glloq/Orchestrion_ukulele/img/schemas principe.png

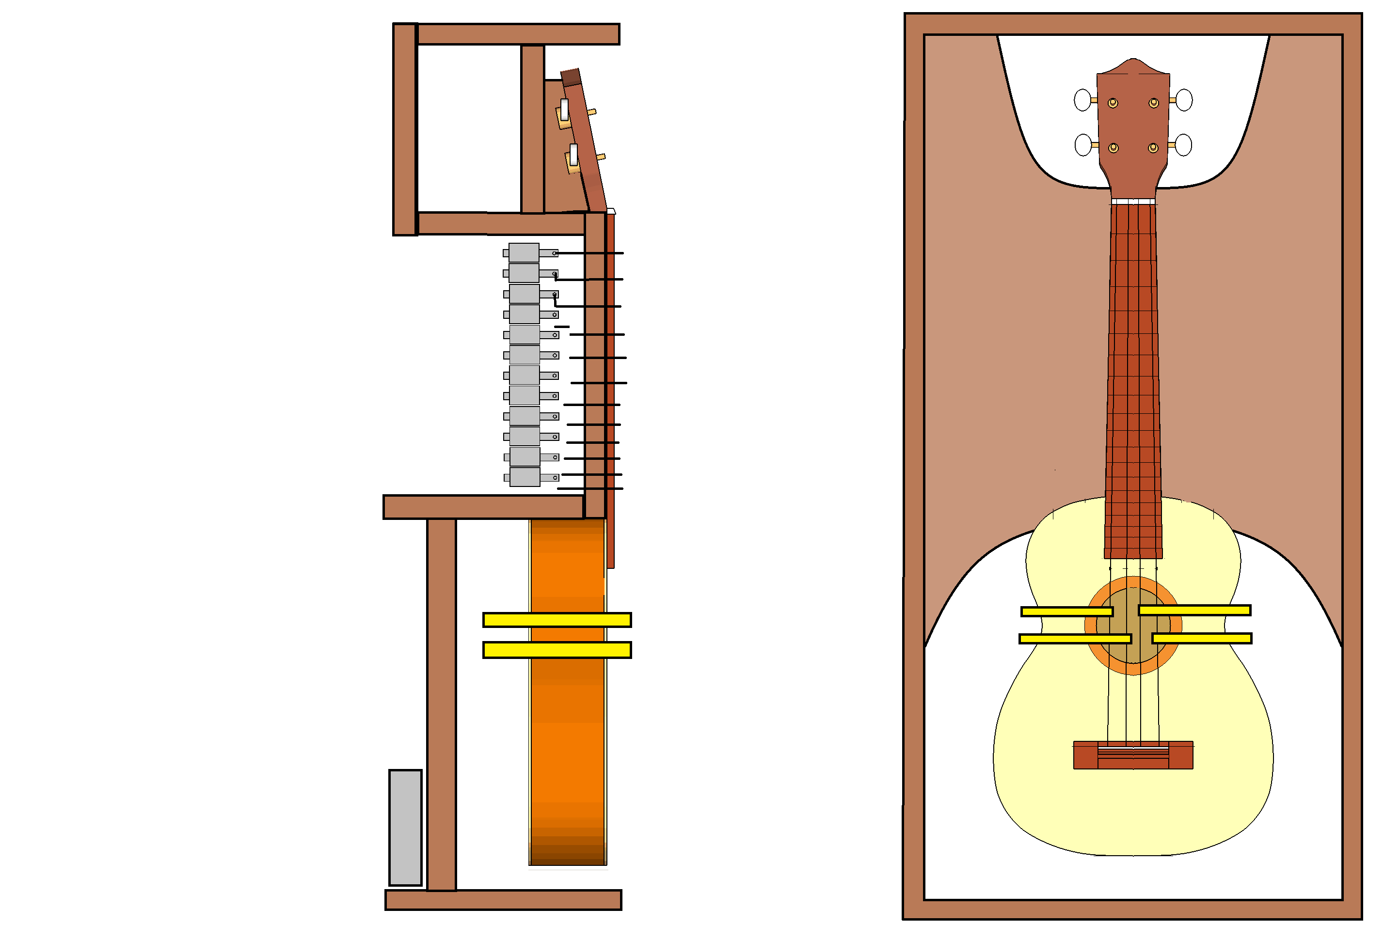
img/schemas principe.png
