glloq/Orchestrion_ukulele/(commit log)

2023-09-27 Create ukulele-servos-init.ino
    code pour remplir les angles des servomoteur de grattage dans settings.h
2025-02-12 Add files via upload
    update code to use less solenoids ans only 2 mcp
